WUSTL-Delivery/delivery-robo/deployment/README.md

# Deployment — the robot Pi

The robot's compute is a Raspberry Pi, hostname `raspi`, user `delivery`,
running **ROS 2 Jazzy** installed natively at `/opt/ros/jazzy`. The repo is
cloned at `~/delivery-robo`.

## Connecting

```sh
ssh delivery@raspi.local     # mDNS; use the IP if .local doesn't resolve
```

(Ask a team member for the password / current WiFi. The Pi joins WiFi via
`wpa_supplicant.conf` in the home directory.)

## What runs at boot

`deployment/startup.sh`, run as a systemd service (`robot.service`). On every
start it:

1. `git fetch` + fast-forward to `origin/main` (20 s timeout — skipped when
   offline, refused if someone edited files directly on the Pi so local
   changes are never clobbered);
2. rebuilds `ros2_ws` with colcon **only if** the repo moved or there is no
   install yet (build failure falls back to the previous install);
3. reads `deployment/robot_config.yaml` and launches
   `ros2 launch my_bringup master_launch.py mode:=<mode>`.

So the normal deploy flow is: **merge to `main`, then reboot the robot** (or
`sudo systemctl restart robot.service`). No hand-building on the Pi.

## Robot config (`deployment/robot_config.yaml`)

```yaml
mode: teleop        # teleop | autonomous | autonomy
sim: false          # laptop testing only, see "Testing with the sim" below
robot_id: robo-1    # name shown on the robo-web dashboard
api_url: https://robo-web-ebon.vercel.app   # robo-web base URL (no trailing slash)
# ros_domain_id: 42 # optional: DDS domain for every node started at boot
```

- `teleop` — wired joystick: `joy_node` + `joystick_control/joystick_node`
  (the setup verified working on the Pi).
- `autonomous` — sensor stack only: RTK GPS + NTRIP (`ublox_dgnss`), IMU. Nothing drives.
- `autonomy` — the full stack: sensors, `hardware_bringup` drive chain (joystick →
  `twist_mux` → `arduino_bridge` → Arduino) and the `delivery-autonomy` nodes (GPS datum,
  EKF, OSM planner, MPPI controller). The joystick overrides the controller whenever its
  enable button is held. See [Autonomy mode](#autonomy-mode) below.

The committed file is the default for every Pi. To change the mode on one
robot without a git commit (a local edit to a tracked file would block the
boot-time `git pull`), copy it to `deployment/robot_config.local.yaml`
(gitignored) — that file wins when present. `ROBOT_CONFIG=/path/to.yaml`
overrides both. Unknown/missing mode falls back to `teleop`.

The same switch works by hand:
`ros2 launch my_bringup master_launch.py mode:=autonomous`.

- `robot_id` / `api_url` — identity and endpoint for the status heartbeat
  (see below). Fill in `api_url` with the Vercel URL of `../robo-web`.

Note: the ros2_control drive stack (`launch_real_robot.launch.py` in `sim/`)
is still launched manually and must not run together with `mode: autonomy`: both open the
Arduino's serial port.

## Autonomy mode

`mode: autonomy` runs `../plans/autonomy-hardware-integration.md`. What runs, in
`ros2_ws/src/hardware_bringup` (read its `README.md` before the first drive; it has the bench
checklist and the calibration procedure):

| Node | Package | Role |
|---|---|---|
| `arduino_bridge` | hardware_bringup | only owner of the Arduino serial port: `/cmd_vel_out` → motor/servo, encoder → `/odom`, 0.5 s watchdog |
| `joy_node` + `joy_to_cmdvel` | joy, hardware_bringup | joystick → `/cmd_vel_joy` while the enable button is held |
| `twist_mux` | twist_mux (apt) | joystick (priority 100) over controller (10) → `/cmd_vel_out` |
| `gps_datum_tf` | hardware_bringup | gates `/fix` → `/gps/fix`, publishes `map→odom` from the first fix |
| `state_estimation`, `global_planning_server`, `controller_server` | autonomy (submodule) | the delivery-autonomy EKF, planner and MPPI controller with hardware parameters |
| `imu_publisher`, ublox + NTRIP | imu_package, ublox_dgnss | as in `autonomous` |

One-time setup on the Pi (as `delivery`):

```sh
cd ~/delivery-robo && git pull && git submodule update --init      # startup.sh also does this
deployment/install_autonomy_deps.sh                                 # jax, osmnx, geopandas, joy, twist_mux ...
cd ros2_ws && source /opt/ros/jazzy/setup.bash && colcon build --symlink-install --packages-ignore simulation
source install/setup.bash && ros2 run hardware_bringup bench_mppi   # MPPI must fit the 100 ms control tick
```

`install_autonomy_deps.sh` pip-installs into `~/.local` with `--break-system-packages`
(PEP 668). Current `jax` needs numpy 2, so the whole numeric stack (numpy, scipy, pandas,
shapely, pyproj, geopandas, osmnx) comes from pip as one consistent set; the apt copies stay
installed for ROS but are shadowed for this user. Apt-built extensions such as
`python3-opencv` stop importing under numpy 2; nothing in `ros2_ws` uses them.

The planner downloads the OSM footway graph from Overpass on every start and caches it in
`~/.cache/delivery_autonomy/cache` (the launch sets that as its working directory). Start it
once while online; afterwards it starts from the cache.

Datum rule: the EKF's `odom` origin and the `map→odom` transform both come from the first GPS
fix the EKF receives, so **start (and restart) the stack with the robot stationary**.

### Testing with the sim (laptop)

`sim: true` (with `mode: autonomy`) runs the same boot path with delivery-autonomy's Gazebo sim in
place of the robot: `startup.sh` also builds the `simulation` package, and `master_launch.py`
starts `run_simulator.sh` (Gazebo + robot spawn + `ros_gz_bridge`) and `simulation.launch.py`
(robot state publisher, ground truth, RViz) instead of the sensors and the drive chain. The
autonomy nodes come from the same `autonomy_real.launch.py` as on the robot, with sim time, the
sim's `/gps/fix`, `/imu/data` and `/odom`, the controller on the sim's `/cmd_vel`, and the fixed
spawn-pose `map→odom` instead of `gps_datum_tf`. No joystick, `twist_mux` or bridge.

Gazebo and the autonomy Python deps come from delivery-autonomy's Nix flake, not from
`/opt/ros/jazzy`, so run the boot script inside its devshell with `ROS_SETUP=` (use the ROS
already in the environment). Use a clone of this repo that is not your Jazzy workspace (the
build goes to its `ros2_ws/install`), and a config outside git:

```sh
cat > /tmp/sim.yaml <<'EOF'
mode: autonomy
sim: true
ros_domain_id: 57              # keep the sim off everyone else's domain
robot_id: laptop-sim
api_url: http://127.0.0.1:9    # don't report the laptop to the robo-web dashboard
EOF
cd ~/coding-projects/delivery-autonomy && nix develop --command \
  nix run --impure github:nix-community/nixGL#nixGLIntel -- env ROS_SETUP= \
  REPO=<clone> BRANCH=<branch> ROBOT_CONFIG=/tmp/sim.yaml QT_QPA_PLATFORM=xcb \
  <clone>/deployment/startup.sh              # HEADLESS=1 hides the Gazebo window
```

`nixGLIntel` (nixGL's Mesa wrapper; it covers AMD too) is only for non-NixOS hosts such as
Ubuntu/Pop!_OS: without it the Nix-built Gazebo and RViz find no GL driver (`Unable to create
glx fbconfig`), and Gazebo segfaults as soon as the robot's camera and lidar start rendering.

Then, in another `nix develop` shell with `ROS_DOMAIN_ID=57` and `<clone>/ros2_ws/install`
sourced, send a goal with a node id from the planner's `Sample Node IDs for testing:` line:
`python3 <clone>/ros2_ws/src/delivery-autonomy/src/autonomy/autonomy/behavior.py <node_id>`.

### NTRIP credentials

`master_launch.py` still carries the historical caster settings as defaults (they are in git
history; rotate the password). To use new credentials without a commit, create the gitignored
`deployment/ntrip.local.yaml`:

```yaml
host: 168.166.125.30
port: 2101
mountpoint: RTX_RTCM34
username: <user>
password: <password>
use_https: false
```

Any key left out keeps the committed default.

## Status heartbeat (robo-web)

The robot reports itself to the `robo-web` dashboard (separate repo,
`../robo-web`, deployed on Vercel) so nobody has to hunt for IPs at a demo.
Two things send it:

1. **`startup.sh`** fires a fire-and-forget `curl -m 5` POST at the very top
   (`state: booting`, `stage: startup.sh`) and again right before the launch
   (`stage: launching`) — so the robot shows up on the dashboard seconds after
   power-on, long before ROS is up. Unreachable API = 5 s lost, nothing else.
2. **`my_bringup/heartbeat_node`** (`ros2_ws/src/my_bringup/my_bringup/heartbeat_node.py`),
   started by `master_launch.py` in every mode with `respawn=True`. Every
   `interval_s` (5 s) it POSTs a full status; network errors are logged
   (throttled to one warning / 30 s) and never crash the node.
   `state` is `booting` until the node has been up one interval and sees at
   least one other ROS node, then it becomes the mode (`teleop`/`autonomous`).

By hand:

```sh
ros2 run my_bringup heartbeat_node --ros-args -p api_url:=https://x.vercel.app -p robot_id:=robo-1
ros2 launch my_bringup master_launch.py mode:=teleop robot_id:=robo-1 api_url:=https://x.vercel.app
```

### API contract

- `POST <api_url>/api/heartbeat` — JSON body; the server upserts the robot by
  `id` and stamps `last_seen`. All fields except `id` are optional:

  ```json
  {
    "id": "robo-1",
    "state": "booting | teleop | autonomous",
    "mode": "teleop",
    "stage": "startup.sh | launching | ros",
    "hostname": "raspi",
    "ips": ["10.0.0.12"],
    "uptime_s": 83.4,
    "git_sha": "0356c3e",
    "ros_distro": "jazzy",
    "ros_nodes": ["joy_node", "control_node"],
    "ros_topics": ["/joy", "/cmd_vel"],
    "cpu_temp_c": 51.0,
    "load_avg": [0.5, 0.4, 0.3],
    "last_joy_age_s": 0.3,
    "last_cmd_vel": {"linear_x": 0.2, "angular_z": 0.0},
    "heartbeat_seq": 42,
    "ts": 1787943000.0
  }
  ```

- `POST <api_url>/api/status` — `{"id": "robo-1", "state": "dead"}`; used by the
  dashboard itself to mark a robot dead after 20 s without a heartbeat
  (Vercel has no free long-running timers, so the browser does it).
- `GET <api_url>/api/robots` — list of every known robot with its last
  payload and `last_seen`.

## Installing / re-wiring the service on the Pi

```sh
cd ~/delivery-robo && git pull
chmod +x deployment/startup.sh
sudo cp deployment/robot.service /etc/systemd/system/
sudo systemctl daemon-reload
sudo systemctl enable --now robot.service
```

Checking on it:

```sh
systemctl status robot.service          # running? enabled?
systemctl is-enabled robot.service      # "enabled" = starts on boot
journalctl -u robot.service -f          # live logs (launch output goes here)
```

Each run overwrites `~/.local/state/delivery-robo/latest-startup.log`, so the
file always contains output from the latest startup:

```sh
tail -F ~/.local/state/delivery-robo/latest-startup.log
cat ~/.local/state/delivery-robo/latest-startup.log   # share this when debugging
```

The log captures stdout and stderr from Git, colcon, ROS setup files, and the
ROS launch, while keeping output in the terminal and journal. Timestamped
stage markers and command exit codes show the repository state, fetch/merge
results (including fetch timeouts), build decisions, config parsing, setup
results, and heartbeat HTTP errors. Logging starts before fetching so failures
to locate the repo are recorded too. The script hands off to ROS with `exec`;
ROS output continues in the log, and systemd records its eventual exit status.

Set `ROBOT_LOG_DIR=/path/to/logs` to choose another directory (use a systemd
environment override when running as a service). If the log directory cannot
be written, startup prints a warning and continues with console/journal output.
Timestamped logs created by older versions are left in place; new runs reuse
`latest-startup.log` without creating additional files.

## History

The script that was found running on the Pi (uncommitted, ~/startup.sh)
was:

```bash
#!/bin/bash
source /opt/ros/jazzy/setup.bash
source ~/delivery-robo/ros2_ws/install/setup.bash
ros2 launch my_bringup master_launch.py
# ros2 run joystick_control joystick_node &
#ros2 run joy joy_node &
```

`deployment/startup.sh` supersedes it (same launch, plus pull-and-rebuild).
When switching to the service, remove the old wiring for `~/startup.sh` so it
doesn't start twice.

## Pi setup notes (not yet automated)

Things the Pi needs that no script installs yet — verify when reimaging:

- pip: `adafruit-circuitpython-bno08x` (+ Blinka `board`/`busio`) for the IMU;
  `pyserial` for the serial nodes. `deployment/install_autonomy_deps.sh` covers the
  autonomy-mode Python packages (`deployment/autonomy-requirements.txt`).
- apt/ROS: `ublox_dgnss` (+ ntrip client), `twist_mux`, `joy`, `ros2_control` stack
- serial ports: the Arduino and the u-blox can swap `ttyUSB` numbers across reboots. Point
  `arduino_bridge`'s `port` (hardware_bringup `config/hardware.yaml`) at the stable
  `/dev/serial/by-id/usb-...` symlink (`ls -l /dev/serial/by-id/`)
- user groups: `dialout` (serial), `i2c`
- the `serial` package must be built with
  `colcon build --packages-select serial --cmake-args -DCMAKE_POSITION_INDEPENDENT_CODE=ON`
- `rplidar_sdk` is checked out at `~/rplidar_sdk` (lidar not yet wired into
  any launch)
- stray copies exist in the home dir (`~/relivery-robo-old`, a loose
  `~/build`/`~/install`) — do not source those by accident

## WiFi: hotspot first, wustl-guest fallback

`deployment/wifi/` sets wlan0 up with `wpa_supplicant@wlan0` (priority-ordered
SSIDs) + `systemd-networkd` DHCP. The hotspot has `priority=10`, `wustl-guest-2.0`
`priority=1` (lab wifi `wurc5` at 5), so the Pi joins the hotspot whenever it's in range and drops to
wustl-guest otherwise (and switches back when the hotspot returns). One-time
install on the Pi:

```sh
HOTSPOT_SSID='<ssid>' HOTSPOT_PSK='<password>' sudo -E deployment/wifi/install.sh
```

## RPLidar C1 (`/dev/rplidar` udev symlink)

The SLAMTEC RPLidar C1 (USB-C to USB into the Pi) is a CP2102 USB-serial
device (`10c4:ea60`, 460800 baud). `deployment/udev/99-rplidar.rules` gives
it a stable `/dev/rplidar` symlink, so the `sllidar_ros2` driver never has to
guess which `/dev/ttyUSBn` it got. The link appears on plug-in and vanishes
on unplug — no reboot needed.

Install (one-time per Pi, idempotent — re-run after editing the rule):

```sh
cd ~/delivery-robo
sudo deployment/udev/install_udev.sh
```

It copies the rule to `/etc/udev/rules.d/`, runs
`udevadm control --reload-rules` + `udevadm trigger`, and adds `delivery`
to `dialout` (effective after re-login/reboot; the rule also sets
`MODE=0666` so the port opens before that).

Verify:

```sh
ls -l /dev/rplidar            # -> lrwxrwxrwx ... /dev/rplidar -> ttyUSB0
udevadm info -q symlink -n /dev/ttyUSB0   # should list "rplidar"
# unplug the C1: /dev/rplidar must disappear
```

### Pinning to the C1's serial (do this if any other CP2102 is attached)

The default rule matches **any** CP2102. The IMU (BNO08x) is on I2C and the
u-blox GPS enumerates as `ttyACM*`, so neither collides — but the wheel
encoder's microcontroller shows up as `/dev/ttyUSB*`, and if its board uses a
CP2102 (common on ESP32 boards) it would also get `/dev/rplidar`. Check with
`lsusb` (look for more than one `10c4:ea60`). If so, pin the rule:

1. Plug in only the C1, then read its serial:
   ```sh
   udevadm info -a -n /dev/ttyUSB0 | grep -m1 'ATTRS{serial}'
   ```
2. In `deployment/udev/99-rplidar.rules`, comment out RULE A, uncomment
   RULE B and replace `REPLACE_WITH_C1_SERIAL` with that value.
3. `sudo deployment/udev/install_udev.sh`, plug the other board back in, and
   confirm `ls -l /dev/rplidar` still points at the C1's tty.

Note: the wheel-encoder node defaults to `port:=/dev/ttyUSB0`; with the C1
also plugged in, which device gets `ttyUSB0` depends on enumeration order,
so pass the encoder its own port (or give it its own udev symlink).

## RealSense depth camera

An Intel RealSense D4xx on a **USB 3** port. The driver is Intel's
`realsense2_camera` from apt. `master_launch.py` starts it in both modes,
with `my_bringup/depth_obstacles` next to it. `realsense:=false` turns both
off. Params are in `ros2_ws/src/my_bringup/config/realsense.yaml`.

One-time setup (Pi or laptop):

```sh
sudo apt install ros-jazzy-realsense2-camera ros-jazzy-librealsense2
sudo deployment/udev/install_udev.sh   # also installs 99-realsense-libusb.rules
```

The apt package ships no udev rules. Without `99-realsense-libusb.rules`
(Intel's, vendored from librealsense v2.58.4), the driver can't open the
camera as a normal user.

Topics (namespace '' + node name `camera`, so no `/camera/camera/...`):

- `/camera/color/image_raw`, `/camera/depth/image_rect_raw`,
  `/camera/aligned_depth_to_color/image_raw` (+ `camera_info`), 640x480@15
- `/camera/obstacles`: `PointCloud2` in `camera_depth_optical_frame`. These are
  the depth points 0.05-1.0 m above the ground, so floor and overhangs are removed.
- `/camera/scan`: `LaserScan` in `base_link`, the same obstacles flattened.
  A finite range is a hit, `+inf` means floor seen and free, `NaN` means no data.
- TF `base_link -> camera_link` comes from the URDF (`camera_*` properties in
  `robot.urdf.xacro`). The driver adds `camera_link -> camera_*_optical_frame`.

Hot-plug is handled by the driver itself: it waits for a camera at startup and
reconnects after an unplug (`reconnect_timeout`).

## Lidar -> costmap

`ros2_ws/src/my_bringup/config/costmap_lidar.example.yaml` is an **example, not
launched** Nav2 (Jazzy) params snippet for when costmap work starts (here or in
delivery-autonomy's MPPI stack). It defines `local_costmap` (global frame
`odom`) and `global_costmap` (global frame `map`), each with an
`obstacle_layer` + `inflation_layer` fed by one observation source `scan`:
`/scan_filtered` (LaserScan, `sensor_frame: lidar_link`), marking + clearing,
`obstacle_max_range: 8.0`, `raytrace_max_range: 10.0`,
`robot_base_frame: base_link`. The footprint is the sim chassis (0.8 x 0.4 m)
until TDM-13 confirms the real one. No launch file loads it — copy the
sections into the real Nav2 params file when wiring it up.

What the robot publishes for Nav2 (both modes, from `master_launch.py`, while
the C1 is plugged in; `lidar:=false` turns it off):

- `/scan`: raw `sensor_msgs/LaserScan` from `sllidar_node`, ~10 Hz, frame `lidar_link`
- `/scan_filtered`: the same scan with the robot body removed (laser_filters)
- TF `base_footprint -> base_link -> lidar_link` from `robot_state_publisher`

To check that Nav2 really builds a costmap from it (robot-centred, no odometry
needed), run next to the robot stack and view `/costmap` in RViz as a
Map display with Fixed Frame `base_link`:

```bash
sudo apt install ros-jazzy-nav2-costmap-2d ros-jazzy-nav2-lifecycle-manager   # once
ros2 launch my_bringup costmap_check.launch.py            # or scan_topic:=/scan
ros2 launch my_bringup costmap_check.launch.py sources:=camera   # lidar | camera | both
```

`sources` defaults to `both`: the lidar's `/scan_filtered` plus the camera's
`/camera/scan`. The camera source marks obstacles below the lidar plane,
like a shoebox, and clears them again once they're gone. The example config
(`costmap_lidar.example.yaml`) has the same `camera` source.
