WUSTL-Delivery/delivery-robo/ros2_ws/src/robot_description/urdf/robot.urdf.xacro

<?xml version="1.0"?>
<!--
  Delivery robot model (real hardware).

  Ported from delivery-autonomy/src/simulation/urdf/robot.urdf.xacro with all
  <gazebo> tags/plugins removed, so sim and real share the same frame names:

    base_footprint -> base_link -> lidar_link   (scan frame, fixed)
                                -> imu_link     (imu_node stamps this, fixed)
                                -> gps_link     (fixed)
                                -> camera_link  (RealSense mount, fixed; the
                                                 driver adds camera_link ->
                                                 camera_*_optical_frame)
                                -> *_wheel / *_steering_link (moving joints)

  Moving joints (wheels, steering) only get TF once something publishes
  /joint_states; the fixed sensor frames above are unaffected.
-->
<robot name="delivery_robot" xmlns:xacro="http://ros.org/wiki/xacro">

  <!-- ===================== Sensor mounts (edit these) ===================== -->
  <!-- Offsets are from base_link (chassis centre), metres / radians.         -->

  <!-- Provisional mount (2026-09-25, not final): centred on the robot, and
       1.5 ft (0.4572 m) above the BOTTOM of base_link. base_link is the chassis
       centre and the chassis is chassis_height (0.2 m) tall, so its bottom is
       at z = -0.10 and the lidar is at z = 0.4572 - 0.10 = 0.357.
       lidar_link should be the scan plane (optical centre, roughly mid-height
       of the C1's spinning head): if the 1.5 ft is to the C1's base instead,
       add ~0.02. Final numbers + yaw come from TDM-13 / TDM-15. -->
  <xacro:property name="lidar_x" value="0.0"/>
  <xacro:property name="lidar_y" value="0.0"/>
  <xacro:property name="lidar_z" value="0.357"/>
  <xacro:property name="lidar_yaw" value="0.0"/>

  <!-- TODO(TDM-13): replace with measured values.
       Placeholders are the sim's values. -->
  <xacro:property name="imu_x" value="0.0"/>
  <xacro:property name="imu_y" value="0.0"/>
  <xacro:property name="imu_z" value="0.1"/>
  <xacro:property name="imu_yaw" value="0.0"/>

  <!-- Intel RealSense depth camera. camera_link is the RealSense driver's own
       root frame (x forward, y left, z up; origin at the depth module's left
       imager, ~1.75 cm left of the camera body's centre on a D435). The driver
       publishes camera_link -> camera_{depth,color}_optical_frame, so the pose
       here is the only mount calibration. pitch > 0 tilts the camera DOWN
       (REP-103: +pitch about +y).
       Provisional (2026-09-26, eyeballed): slightly in front of and above the
       chassis box, i.e. ~5 cm past its front edge (x = 0.40) and ~5 cm above
       its top (z = 0.10), level. Measured values come from TDM-6. -->
  <xacro:property name="camera_x" value="0.45"/>
  <xacro:property name="camera_y" value="0.0"/>
  <xacro:property name="camera_z" value="0.15"/>
  <xacro:property name="camera_pitch" value="0.0"/>
  <xacro:property name="camera_yaw" value="0.0"/>

  <!-- ============================ Chassis ================================= -->
  <xacro:property name="chassis_length" value="0.8"/>
  <xacro:property name="chassis_width" value="0.4"/>
  <xacro:property name="chassis_height" value="0.2"/>
  <xacro:property name="wheel_radius" value="0.15"/>
  <xacro:property name="wheel_width" value="0.08"/>
  <xacro:property name="wheel_mass" value="2.0"/>
  <xacro:property name="chassis_mass" value="20.0"/>
  <xacro:property name="wheelbase" value="0.5"/>
  <xacro:property name="track_width" value="0.55"/>

  <xacro:macro name="box_inertia" params="m w h d">
    <inertial>
      <mass value="${m}"/>
      <inertia ixx="${m/12 * (h*h + d*d)}" ixy="0" ixz="0" iyy="${m/12 * (w*w + d*d)}" iyz="0" izz="${m/12 * (w*w + h*h)}"/>
    </inertial>
  </xacro:macro>

  <xacro:macro name="cylinder_inertia" params="m r h">
    <inertial>
      <mass value="${m}"/>
      <inertia ixx="${m*(3*r*r + h*h)/12}" ixy="0" ixz="0" iyy="${m*(3*r*r + h*h)/12}" iyz="0" izz="${m*r*r/2}"/>
    </inertial>
  </xacro:macro>

  <link name="base_footprint"/>

  <link name="base_link">
    <visual>
      <geometry>
        <box size="${chassis_length} ${chassis_width} ${chassis_height}"/>
      </geometry>
      <material name="orange"><color rgba="1 0.5 0 1"/></material>
    </visual>
    <collision>
      <geometry>
        <box size="${chassis_length} ${chassis_width} ${chassis_height}"/>
      </geometry>
    </collision>
    <xacro:box_inertia m="${chassis_mass}" w="${chassis_width}" h="${chassis_height}" d="${chassis_length}"/>
  </link>

  <joint name="base_joint" type="fixed">
    <parent link="base_footprint"/>
    <child link="base_link"/>
    <origin xyz="0 0 ${wheel_radius}" rpy="0 0 0"/>
  </joint>

  <!-- ============================= Wheels ================================= -->
  <xacro:macro name="rear_wheel" params="prefix y_offset">
    <link name="${prefix}_wheel">
      <visual>
        <geometry><cylinder radius="${wheel_radius}" length="${wheel_width}"/></geometry>
        <material name="black"><color rgba="0 0 0 1"/></material>
      </visual>
      <collision>
        <geometry><cylinder radius="${wheel_radius}" length="${wheel_width}"/></geometry>
      </collision>
      <xacro:cylinder_inertia m="${wheel_mass}" r="${wheel_radius}" h="${wheel_width}"/>
    </link>

    <joint name="${prefix}_wheel_joint" type="continuous">
      <parent link="base_link"/>
      <child link="${prefix}_wheel"/>
      <origin xyz="${-wheelbase/2} ${y_offset} ${-chassis_height/2}" rpy="-1.5707 0 0"/>
      <dynamics damping="0.5" friction="0.1"/>
      <axis xyz="0 0 1"/>
    </joint>
  </xacro:macro>

  <xacro:macro name="front_wheel" params="prefix y_offset">
    <link name="${prefix}_steering_link">
      <inertial>
        <mass value="0.1"/>
        <inertia ixx="0.01" ixy="0" ixz="0" iyy="0.01" iyz="0" izz="0.01"/>
      </inertial>
    </link>

    <joint name="${prefix}_steering_joint" type="revolute">
      <parent link="base_link"/>
      <child link="${prefix}_steering_link"/>
      <origin xyz="${wheelbase/2} ${y_offset} ${-chassis_height/2}" rpy="0 0 0"/>
      <axis xyz="0 0 1"/>
      <limit lower="-0.6" upper="0.6" effort="100" velocity="1.0"/>
    </joint>

    <link name="${prefix}_wheel">
      <visual>
        <geometry><cylinder radius="${wheel_radius}" length="${wheel_width}"/></geometry>
        <material name="black"><color rgba="0 0 0 1"/></material>
      </visual>
      <collision>
        <geometry><cylinder radius="${wheel_radius}" length="${wheel_width}"/></geometry>
      </collision>
      <xacro:cylinder_inertia m="${wheel_mass}" r="${wheel_radius}" h="${wheel_width}"/>
    </link>

    <joint name="${prefix}_wheel_joint" type="continuous">
      <parent link="${prefix}_steering_link"/>
      <child link="${prefix}_wheel"/>
      <origin xyz="0 0 0" rpy="-1.5707 0 0"/>
      <dynamics damping="0.5" friction="0.1"/>
      <axis xyz="0 0 1"/>
    </joint>
  </xacro:macro>

  <xacro:rear_wheel prefix="rear_left" y_offset="${track_width/2}"/>
  <xacro:rear_wheel prefix="rear_right" y_offset="${-track_width/2}"/>
  <xacro:front_wheel prefix="front_left" y_offset="${track_width/2}"/>
  <xacro:front_wheel prefix="front_right" y_offset="${-track_width/2}"/>

  <!-- ============================= Sensors ================================ -->
  <link name="lidar_link">
    <visual>
      <geometry><cylinder radius="0.05" length="0.05"/></geometry>
      <material name="blue"><color rgba="0 0 1 1"/></material>
    </visual>
  </link>
  <joint name="lidar_joint" type="fixed">
    <parent link="base_link"/>
    <child link="lidar_link"/>
    <origin xyz="${lidar_x} ${lidar_y} ${lidar_z}" rpy="0 0 ${lidar_yaw}"/>
  </joint>

  <link name="imu_link">
    <visual>
      <geometry><box size="0.02 0.02 0.02"/></geometry>
      <material name="black"><color rgba="0 0 0 1"/></material>
    </visual>
  </link>
  <joint name="imu_joint" type="fixed">
    <parent link="base_link"/>
    <child link="imu_link"/>
    <origin xyz="${imu_x} ${imu_y} ${imu_z}" rpy="0 0 ${imu_yaw}"/>
  </joint>

  <link name="gps_link"/>
  <joint name="gps_joint" type="fixed">
    <parent link="base_link"/>
    <child link="gps_link"/>
    <origin xyz="0 0 0" rpy="0 0 0"/>
  </joint>

  <link name="camera_link">
    <visual>
      <geometry><box size="0.05 0.1 0.05"/></geometry>
      <material name="red"><color rgba="1 0 0 1"/></material>
    </visual>
  </link>
  <joint name="camera_joint" type="fixed">
    <parent link="base_link"/>
    <child link="camera_link"/>
    <origin xyz="${camera_x} ${camera_y} ${camera_z}" rpy="0 ${camera_pitch} ${camera_yaw}"/>
  </joint>

</robot>
