WUSTL-Delivery/delivery-robo/PCB/Robotics.kicad_pcb

## KiCad design PCB/Robotics.kicad_pcb (2026-11-07)

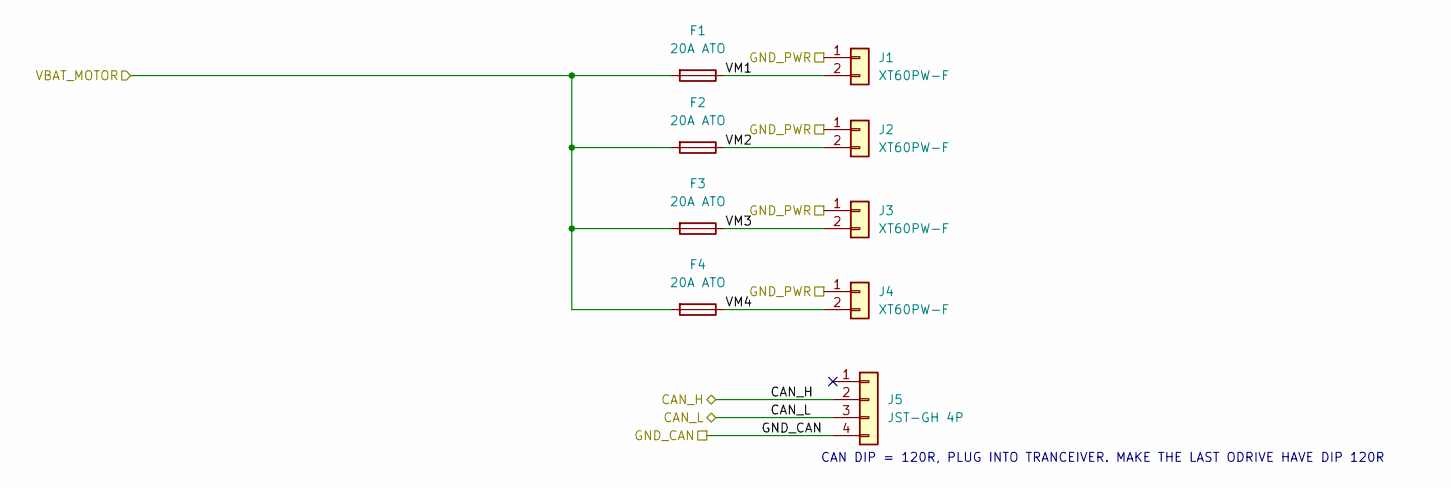
[picture p1: schematic motor copy.kicad_sch]

Parts:
F1, F2, F3, F4: 20A ATO; FuseHolder_Blade_ATO_Littelfuse_FLR_178.6165
J1, J2, J3, J4: XT60PW-F; AMASS_XT60PW-F_1x02_P7.20mm_Horizontal
J5: JST-GH 4P; JST_GH_SM04B-GHS-TB_1x04-1MP_P1.25mm_Horizontal

Connections:
/Motor Distribution/CAN_H: J5.2; also elsewhere on the board
/Motor Distribution/CAN_L: J5.3; also elsewhere on the board
/Motor Distribution/GND_PWR: J1.1, J2.1, J3.1, J4.1; also elsewhere on the board
/Motor Distribution/VBAT_MOTOR: F1.2, F2.2, F3.2, F4.2; also elsewhere on the board
/Motor Distribution/VM1: F1.1, J1.2
/Motor Distribution/VM2: F2.1, J2.2
/Motor Distribution/VM3: F3.1, J3.2
/Motor Distribution/VM4: F4.1, J4.2
GND: J5.4; also elsewhere on the board

Notes on the sheet:
CAN DIP = 120R, PLUG INTO TRANCEIVER. MAKE THE LAST ODRIVE HAVE DIP 120R

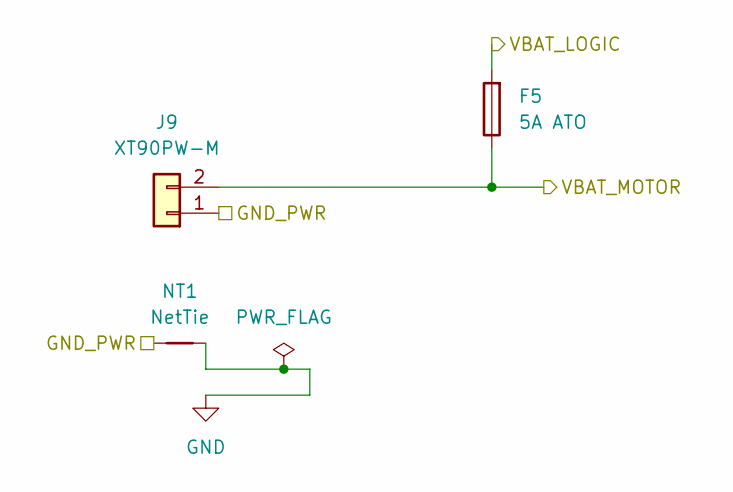
[picture p2: schematic power_sensing copy.kicad_sch]

Parts:
F5: 5A ATO; FuseHolder_Blade_ATO_Littelfuse_FLR_178.6165
J9: XT90PW-M; AMASS_XT90PW-M_1x02_P10.90mm_Horizontal
NT1: NetTie; NetTie-2_SMD_Pad2.0mm

Connections:
/5V Logic and Sensors/VBAT_LOGIC: F5.2; also elsewhere on the board
/Motor Distribution/GND_PWR: J9.1, NT1.1; also elsewhere on the board
/Motor Distribution/VBAT_MOTOR: F5.1, J9.2; also elsewhere on the board
GND: NT1.2; also elsewhere on the board

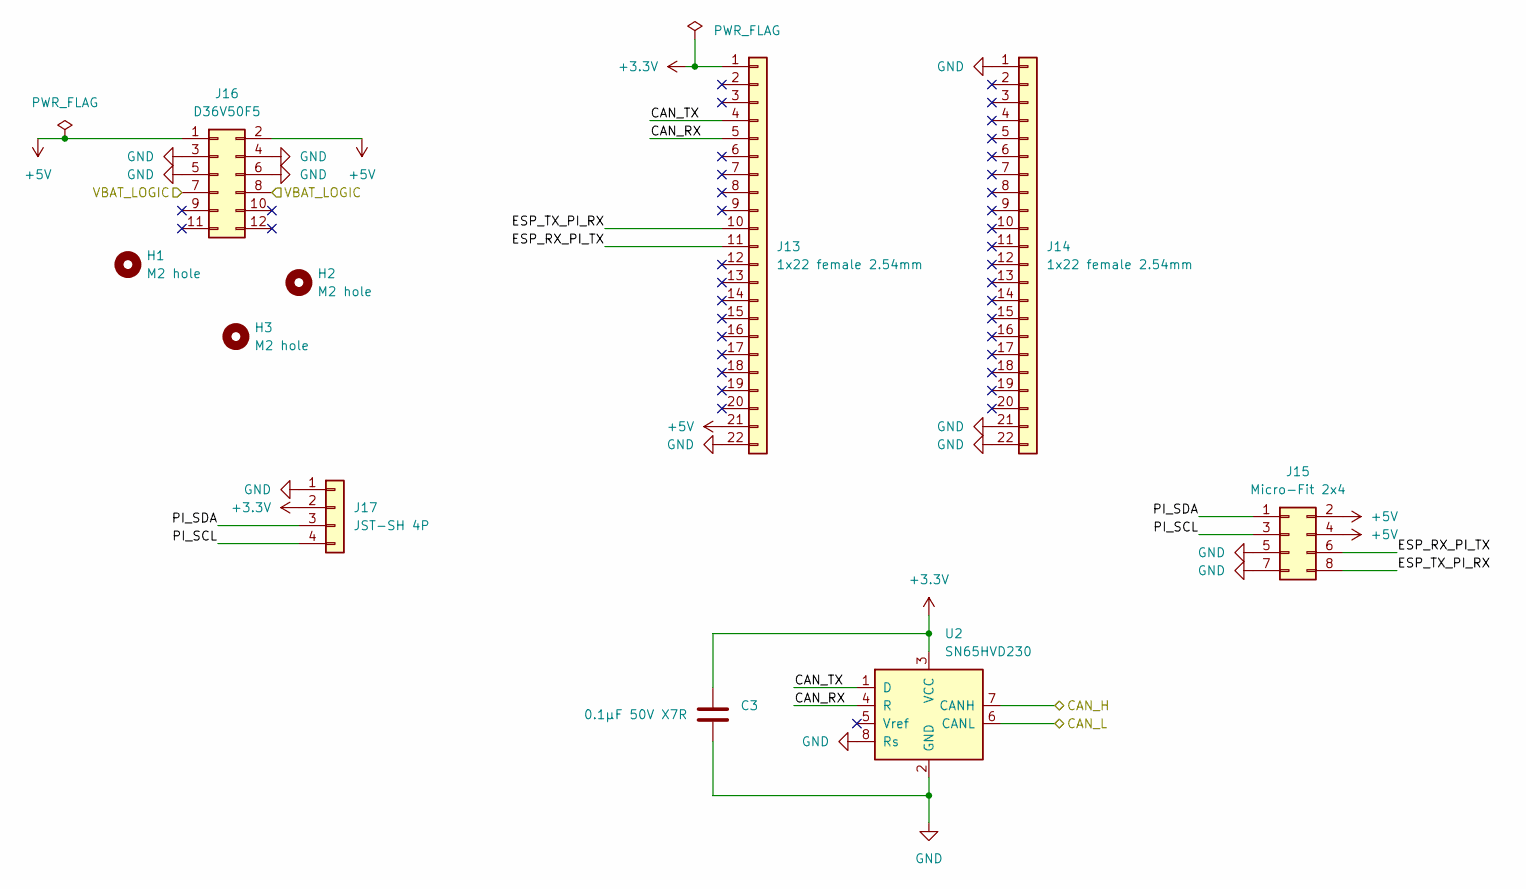
[picture p3: schematic sensor.kicad_sch]

Parts:
C3: 0.1µF 50V X7R; C_0805_2012Metric
H1, H2, H3: M2 hole; MountingHole_2.2mm_M2
J13, J14: 1x22 female 2.54mm; PinSocket_1x22_P2.54mm_Vertical
J15: Micro-Fit 2x4; Molex_Micro-Fit_3.0_43045-0812_2x04_P3.00mm_Vertical
J16: D36V50F5; PinHeader_2x06_P2.54mm_Vertical
J17: JST-SH 4P; JST_SH_SM04B-SRSS-TB_1x04-1MP_P1.00mm_Horizontal
U2: SN65HVD230; SOIC-8_3.9x4.9mm_P1.27mm

Connections:
+3.3V: C3.1, J13.1, J17.2, U2.3 (VCC)
+5V: J13.21, J15.2, J15.4, J16.1, J16.2
/5V Logic and Sensors/CAN_RX: J13.5, U2.4 (R)
/5V Logic and Sensors/CAN_TX: J13.4, U2.1 (D)
/5V Logic and Sensors/ESP_RX_PI_TX: J13.11, J15.6
/5V Logic and Sensors/ESP_TX_PI_RX: J13.10, J15.8
/5V Logic and Sensors/PI_SCL: J15.3, J17.4
/5V Logic and Sensors/PI_SDA: J15.1, J17.3
/5V Logic and Sensors/VBAT_LOGIC: J16.7, J16.8; also elsewhere on the board
/Motor Distribution/CAN_H: U2.7 (CANH); also elsewhere on the board
/Motor Distribution/CAN_L: U2.6 (CANL); also elsewhere on the board
GND: C3.2, J13.22, J14.1, J14.21, J14.22, J15.5, J15.7, J16.3, J16.4, J16.5, J16.6, J17.1, U2.2 (GND), U2.8 (Rs); also elsewhere on the board

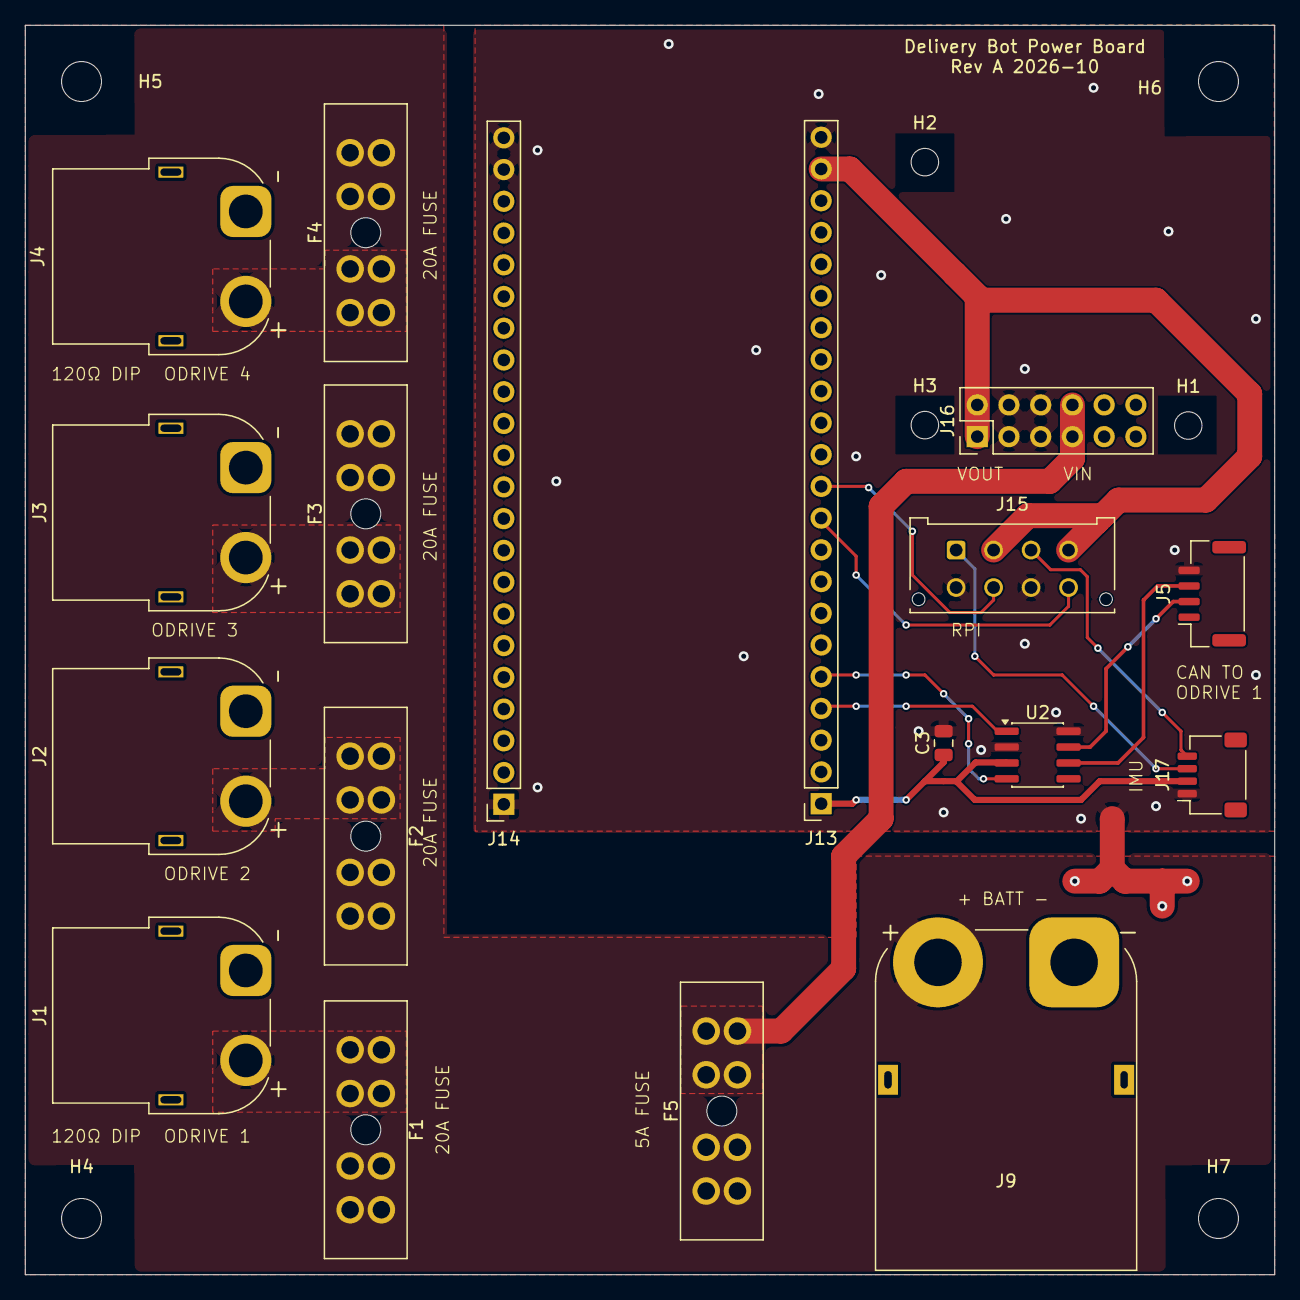
[picture p4: board Robotics.kicad_pcb from above]

Board: 2 copper layers, 100.0 x 100.0 mm, 26 parts (0 on the bottom side), 18 nets.

Other parts of the board:
H4, H5, H6, H7: M3 hole; MountingHole_3.2mm_M3
