WUSTL-Delivery/delivery-robo/(commit log)

2026-09-18 Fix serial buffer reading
    [wheel_encoder_node.py]
2026-09-25 TDM-17: example Nav2 costmap config for /scan_filtered lidar
    Add my_bringup/config/costmap_lidar.example.yaml (not launched): local
    (odom) and global (map) costmaps with obstacle_layer + inflation_layer
    fed by /scan_filtered in lidar_link, robot_base_frame base_link, sim
    chassis footprint 0.8x0.4 m (TODO TDM-13). Document it in
    deployment/README.md.
    Claude-Session: https://claude.ai/code/session_01DbW97hUAn6A8RHwzgBycwz
2026-09-25 TDM-16: laser_filters chain removes lidar self-hits, publishes /scan_filtered
    Add my_bringup/config/laser_filters.yaml (LaserScanBoxFilter in base_link
    around the chassis + LaserScanRangeFilter < 0.15 m) and run
    scan_to_scan_filter_chain in autonomous mode, guarded when laser_filters
    is not installed (sudo apt install ros-jazzy-laser-filters). Install
    config/*.yaml from setup.py; exec_depend laser_filters.
    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
2026-09-25 TDM-14: add robot_description package with lidar_link TF
    Port the sim robot.urdf.xacro (minus Gazebo tags) into a new
    robot_description package. Lidar and IMU mounts are top-of-file xacro
    properties holding the sim placeholder values pending TDM-13 measurements.
    description.launch.py processes the xacro at launch and runs
    robot_state_publisher (plus joint_state_publisher when installed), and
    logs instead of failing when xacro is missing. master_launch.py includes
    it in both modes, guarded by PackageNotFoundError.
    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
    [robot.urdf.xacro]
2026-09-25 TDM-11: RPLidar C1 in master_launch with hot-plug watchdog
    Add sllidar_node (sllidar_ros2) to autonomous mode behind a new lidar:=true
    arg, params in my_bringup/config/lidar.yaml (/dev/rplidar @ 460800,
    frame lidar_link, Standard scan mode), respawn every 3 s, guarded with
    PackageNotFoundError so launch works without the driver built.
    sllidar_node exits when the port is absent at startup (respawn retries), but
    spins forever on read timeouts after a mid-run unplug; lidar_watchdog SIGINTs
    it after 5 s without /scan (SIGKILL fallback) so respawn reopens the device.
    Claude-Session: https://claude.ai/code/session_01DbW97hUAn6A8RHwzgBycwz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
2026-09-25 lidar_watchdog: ignore a second SIGINT during shutdown
2026-09-25 Fix boot submodule sync on fresh clones; set provisional lidar mount
    startup.sh: a bare 'git submodule update' aborts on the repo's orphaned
    gitlinks (librealsense, ublox_dgnss, sim/src/serial) before fetching
    sllidar_ros2, so a fresh Pi clone never got the driver. Update only the
    paths registered in .gitmodules.
    robot_description: lidar centred on the robot, 1.5 ft above the bottom of
    base_link (z = 0.357 from the chassis centre). Provisional until TDM-13.
    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
    [robot.urdf.xacro]
2026-09-25 master_launch: don't rename the laser_filters process
    name= remaps every node in the process; the box filter runs its own
    internal node, so both became /scan_to_scan_filter_chain and parameter
    services broke. The default name already matches laser_filters.yaml.
    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
2026-09-25 Run the lidar in both modes; add a Nav2 costmap check launch
    The Pi boots in teleop (robot_config.yaml), where the lidar did not start,
    so /scan was never published at boot. The driver, watchdog and
    /scan_filtered now run in both modes (lidar:=false still disables them),
    alongside the robot model TF.
    costmap_check.launch.py runs a standalone Nav2 costmap (robot-centred,
    no odometry) on /scan_filtered to prove the scan builds a costmap.
    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
    [robot_config.yaml]
2026-09-26 feat: autonomy integration
    [hardware.yaml, robot_config.yaml]
2026-09-26 feat: sim toggle to test autonomy mode on a laptop
    `sim: true` in robot_config.yaml (mode: autonomy only) swaps the sensors
    and drive chain for delivery-autonomy's Gazebo sim. The autonomy nodes
    still start from autonomy_real.launch.py, with sim time, the sim's
    topics and its fixed map->odom. Default false; the robot path is
    unchanged.
    startup.sh passes sim:= through, builds the simulation package only when
    sim is on, and ROS_SETUP= keeps the ROS already in the environment
    (delivery-autonomy's nix develop). How to run it: deployment/README.md.
    [robot_config.yaml]
2026-09-26 TDM-1: RealSense udev rule, install script, drop orphan librealsense gitlink
    - deployment/udev/99-realsense-libusb.rules: Intel's rules from librealsense
    v2.58.4 (what ros-jazzy-librealsense2 is built from). The apt package
    doesn't install them, and its libusb backend needs them to open the
    camera as a normal user.
    - install_udev.sh installs both rule files and re-triggers usb as well as tty.
    - my_bringup exec_depends on realsense2_camera (apt).
    - Remove ros2_ws/src/librealsense: an empty gitlink with no .gitmodules
    entry; the driver comes from apt.
2026-09-26 TDM-2: launch the RealSense from master_launch (realsense:= arg)
    config/realsense.yaml runs Intel's realsense2_camera_node with color and
    depth at 640x480@15 and align_depth on. The driver pointcloud is off.
    master_launch starts it in both modes, gated by `realsense` (default true).
    Like sllidar_ros2 it is skipped when the driver isn't installed.
    Namespace '' + name 'camera' gives /camera/color/image_raw and
    /camera/depth/image_rect_raw. Hot-plug is left to the driver
    (wait_for_device_timeout -1, reconnect_timeout 6 s).
    [realsense.yaml]
2026-09-26 TDM-3: camera mount as camera_x/y/z/pitch/yaw xacro properties
    camera_link is now the RealSense driver's root frame, placed by editable
    mount properties. The driver hangs camera_*_optical_frame off it.
    Provisional values keep the old placeholder pose until TDM-6 measures it.
    [robot.urdf.xacro]
2026-09-26 TDM-4: depth_obstacles node, depth -> /camera/obstacles + /camera/scan
    Deprojects every 4th depth pixel with numpy (~2.7 ms/frame on the laptop).
    It filters by height above base_footprint, so the floor and anything the
    robot fits under are dropped. It publishes:
    - /camera/obstacles: PointCloud2 in the depth optical frame
    - /camera/scan: LaserScan in base_link with REP-117 bins
    (hit = 3rd-nearest point, +inf = floor seen/free, NaN = no data)
    Unlike depthimage_to_laserscan, a downward-tilted camera doesn't turn the
    floor into a wall. Unit tests ray-cast a synthetic floor+box scene.
    master_launch starts it next to the camera.
    [realsense.yaml]
2026-09-26 TDM-5: camera as a second costmap observation source
    costmap_check gets a `camera` source on /camera/scan, plus a
    `sources:=lidar|camera|both` arg (default both). `lidar` is the old
    config, unchanged. The example Nav2 config gets the same source, and
    deployment/README documents the RealSense setup and topics.
    The source is the LaserScan, not the /camera/obstacles cloud. Its +inf
    ("floor seen, free") bins clear a removed obstacle; the cloud only has
    obstacle points, so it could mark but never clear. obstacle_max_range
    3.9 stays under the node's range_max 4.0, so free bins don't mark.
    Checked on a synthetic depth stream: a 0.25 m box at 1.4 m marks lethal
    cells at x=1.38 and clears after it'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
2026-09-26 fix(startup): skip sllidar_ros2 in sim builds; fix submodule change check
    sim: true builds on the sim's Lyrical, where sllidar_ros2 does not build
    (ament_target_dependencies is gone) and aborted the whole build; the lidar
    is off in the sim anyway. Also report `none` for a not-yet-cloned
    delivery-autonomy instead of the superproject's HEAD.
    Claude-Session: https://claude.ai/code/session_01MFkc7uFzQQf812jwr1m3ob
2026-09-26 master_launch: keep the RealSense off with sim:=true
    Same gating as the lidar: in the Gazebo sim the robot has its own camera
    topics, so the driver and depth_obstacles must not start there.
    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
2026-09-26 TDM-3: provisional camera mount in front of and above the chassis
    Eyeballed with the user: ~5 cm past the chassis front edge (x 0.40 -> 0.45)
    and ~5 cm above its top (z 0.15), level. Laptop test with the D435i gives
    base_link -> camera_depth_optical_frame = (0.45, 0, 0.15) and a single TF
    tree. Measured values still come from TDM-6.
    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
    [robot.urdf.xacro]
2026-10-09 Combine lidar and depth camera obstacles into one scan for the robot costmap
2026-10-24 Register serial submodule with existing commit pin
2026-10-25 Adding PCB Files
2026-10-27 Completed PCB Layout
2026-11-07 updated janky temu esp32
2026-11-07 Consolidate latest PCB: YD-ESP32-S3 spacing, stitching vias, labels
2026-11-07 Add Gerbers
